cdaub-bu/GS_Circuit/KiCad/GS_Circuit/GS_Circuit.csv

Reference | Qty | Value | DIGIKEY | CatNo
J1 | 1 | AVR-ISP-6
XX7 | 1 | Cap Blue | 1DBLU-ND | 1DBLU-ND
XX2 | 1 | Green LED | 1516-1364-ND | 1516-1364-ND
XX4 | 1 | Blue LED | 1516-1365-ND | 1516-1365-ND
XX1 | 1 | White LED | 1516-QBL8IW60D-CW-ND | 1516-QBL8IW60D-CW-ND
XX5 | 1 | DIP-8 Socket | 2057-ICS-308-T-ND | 2057-ICS-308-T-ND
BT1 | 1 | Battery | 36-2464-ND
C1 | 1 | .1 uf | 445-173588-1-ND
XX3 | 1 | Red LED | 67-2288-ND | 67-2288-ND
S1 | 1 | TEPT 4400 | 751-1057-ND
U2 | 1 | ATtiny85V-10P | ATTINY85-20PU-ND
R3,R4 | 2 | 10K | CF14JT10K0CT-ND
R1,R2 | 2 | 91 Ohms | CF14JT91R0CT-ND
XX6 | 1 | Cap Red | EG1195-ND | EG1195-ND
SW2 | 1 | SW_SPST | EG5886-ND
SW1 | 1 | SW_Push | EG5888-ND
D1,D2 | 2 | LED | Various
