cdaub-bu/GS_Circuit/Case/Final/SolderJig3.stl

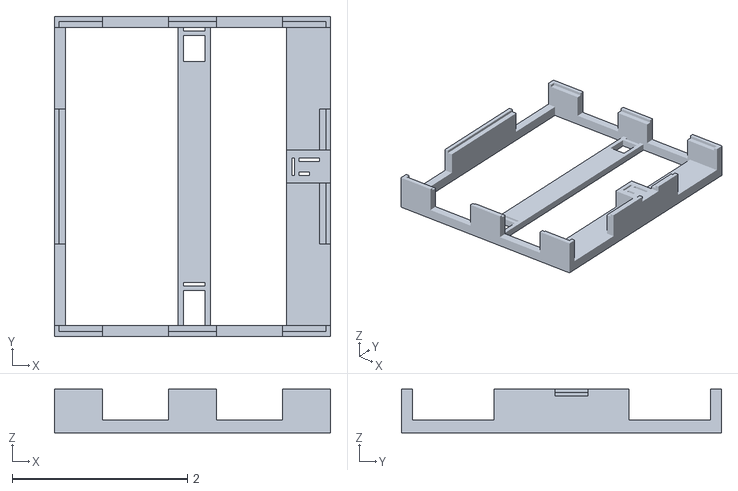
[picture p2: CAD file, 2026-02-10]
Case/Final/SolderJig3.stl
3.15 x 3.65 x 0.5
