cdaub-bu/GS_Circuit/KiCad/GS_Circuit/models/LC1258EENP.step

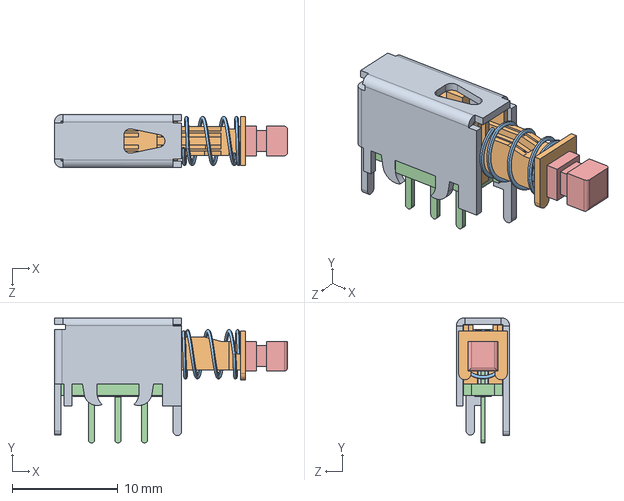
[picture p3: CAD file, 2026-02-01]
KiCad/GS_Circuit/models/LC1258EENP.step
22.0 x 11.8 x 5.00 mm
