cdaub-bu/GS_Circuit/KiCad/GS_Circuit/GS_Circuit.pdf

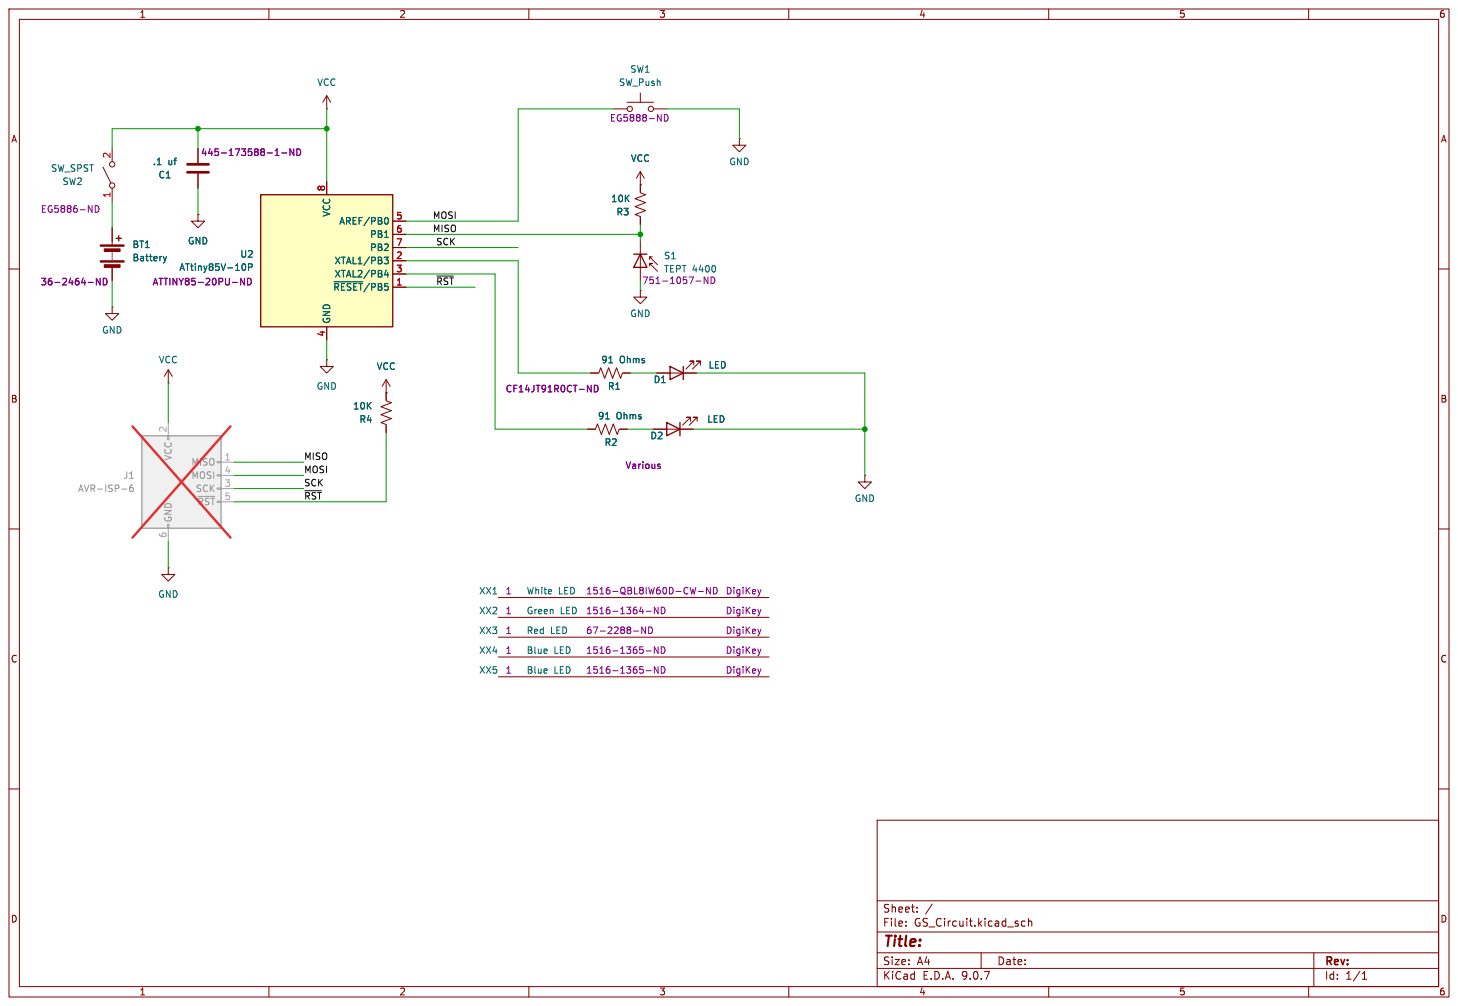
[picture p4: page 1]

4 AREF/PB0 5 PB1 6 PB2 7 XTAL1/PB3 2 XTAL2/PB4 3 ~{RESET}/PB51 BT1 Battery 36-2464-ND

6 MISO 1 MOSI 4 SCK 3 ~{RST}5

Id: 1/1 Title: File: GS_Circuit.kicad_sch Sheet: /
