cdaub-bu/GS_Circuit/KiCad/GS_Circuit/GS_Circuit.kicad_pcb

## KiCad design KiCad/GS_Circuit/GS_Circuit.kicad_pcb (2026-01-20)

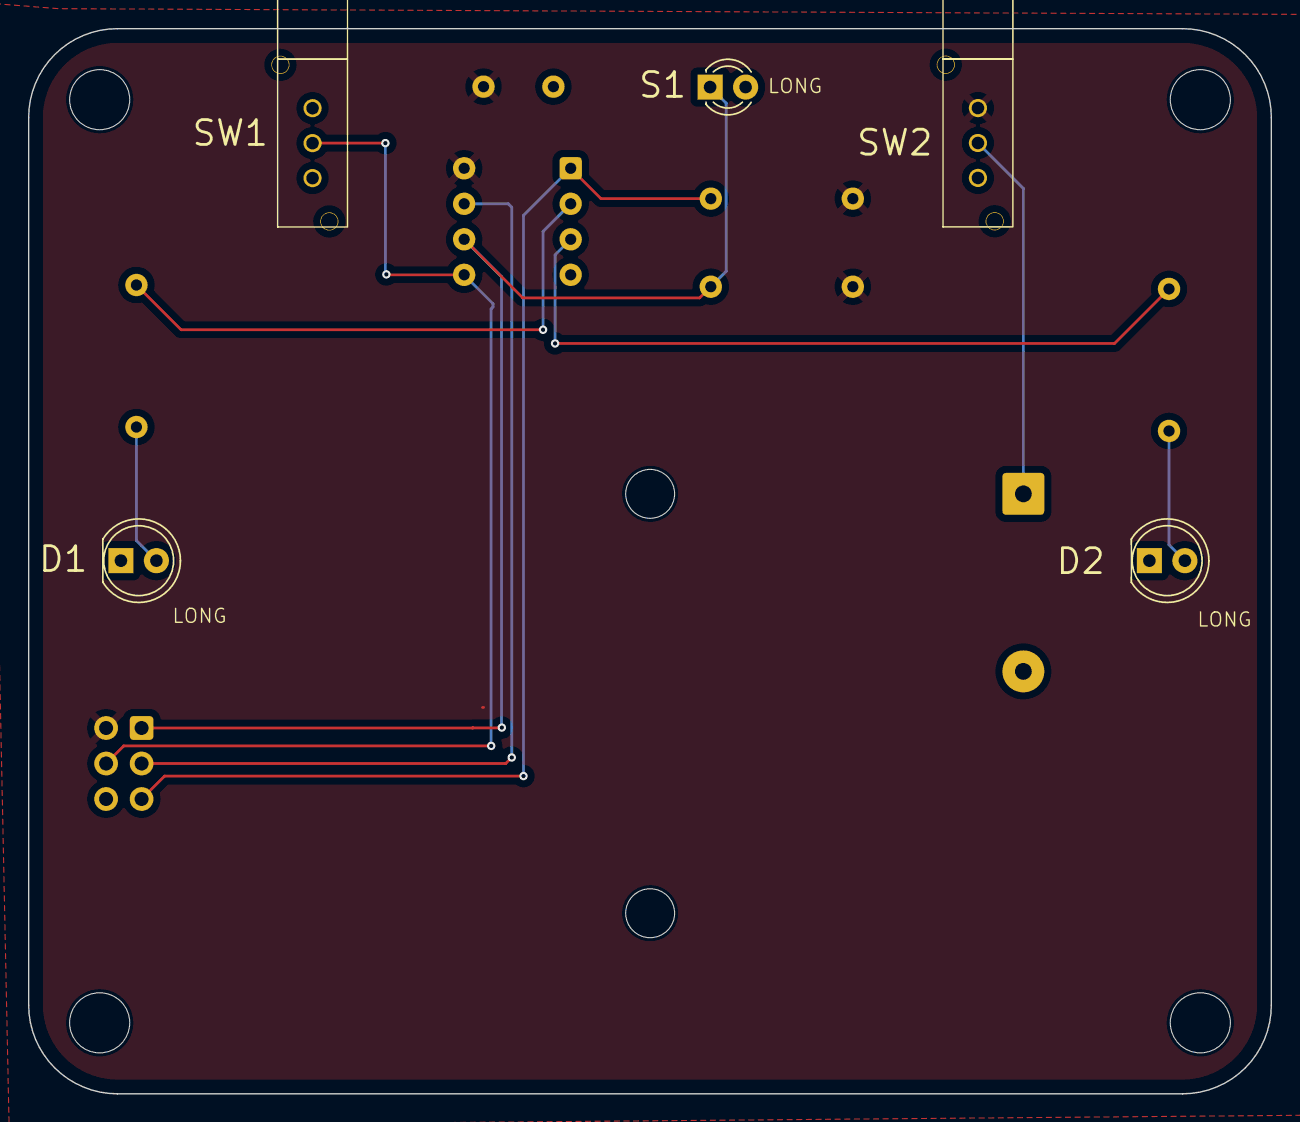
[picture p5: board GS_Circuit.kicad_pcb from above]

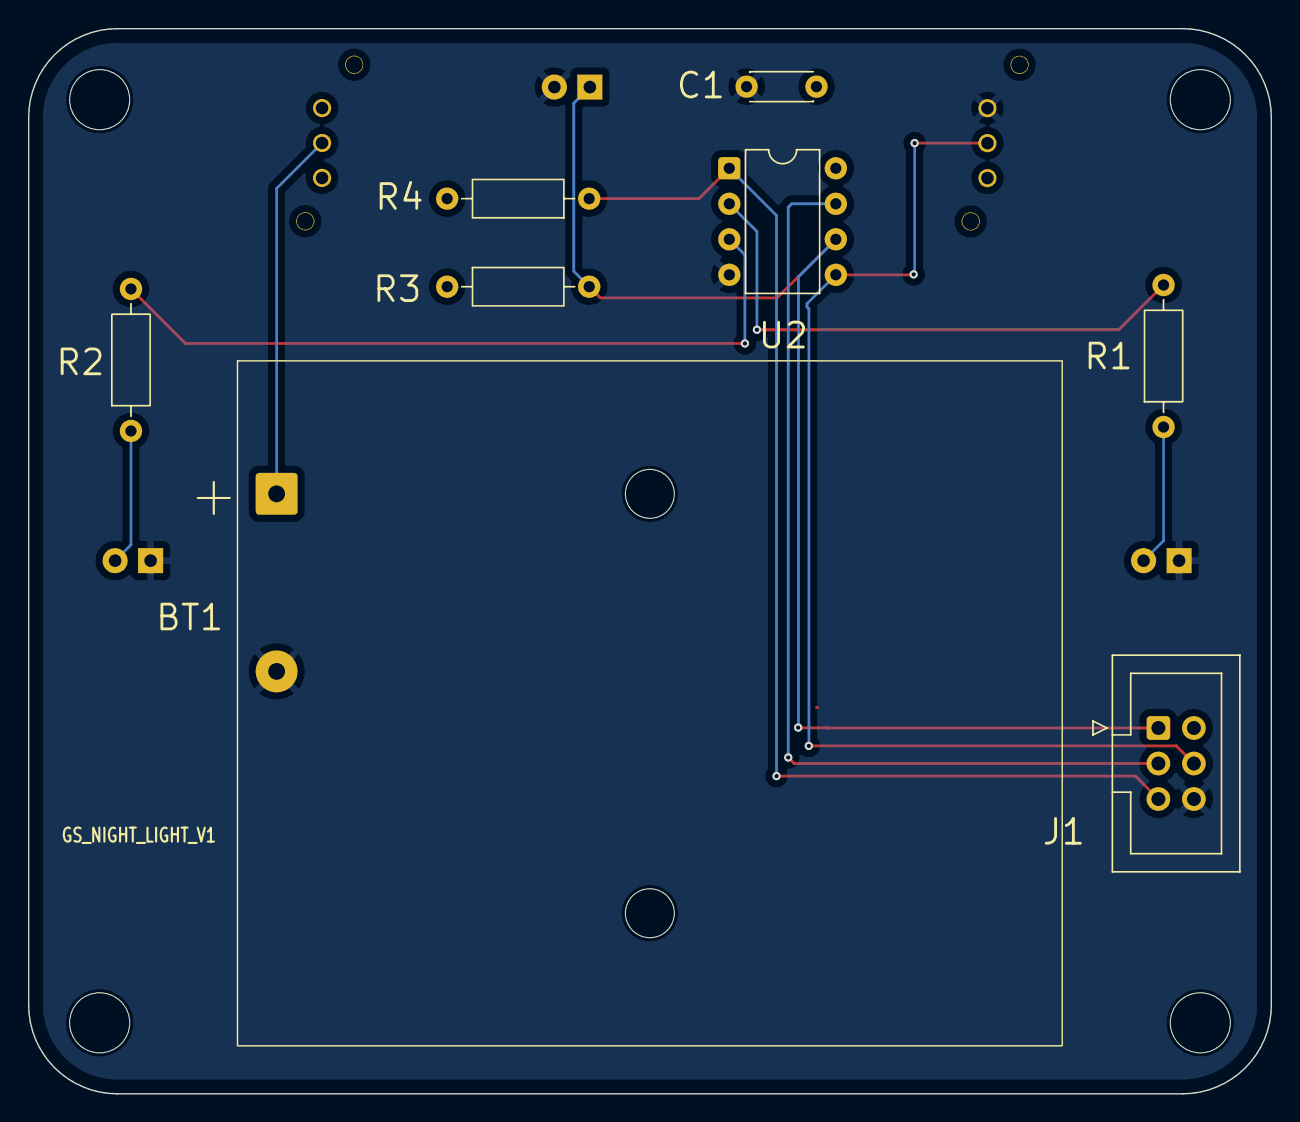
[picture p6: board GS_Circuit.kicad_pcb from below]

Board: 2 copper layers, 88.9 x 76.2 mm, 17 parts (8 on the bottom side), 11 nets.

Parts:
BT1: Battery; BatteryHolder_Keystone_2464
C1: .1 uf; C_Disc_D4.3mm_W1.9mm_P5.00mm
D1, D2: LED, QBL8XX60Y Series; LED_D5.0mm
H1, H2, H3, H4: MountingHole; MountingHole_4.3mm_M4
J1: AVR-ISP-6; IDC-Header_2x03_P2.54mm_Vertical
R1, R2: 91 Ohms; R_Axial_DIN0207_L6.3mm_D2.5mm_P10.16mm_Horizontal
R3: 10K; R_Axial_DIN0207_L6.3mm_D2.5mm_P10.16mm_Horizontal
R4: R_US; R_Axial_DIN0207_L6.3mm_D2.5mm_P10.16mm_Horizontal
S1: TEPT 4400; THT_TEPT4400
SW1: SW_Push; LC 1258
SW2: SW_SPST; LC 1258
U2: ATtiny85V-10P; DIP-8_W7.62mm

Connections:
/MISO: J1.1 (MISO), R3.2, S1.1 (K), U2.6 (PB1)
/MOSI: J1.4 (MOSI), SW1.1, U2.5 (AREF/PB0)
/SCK: J1.3 (SCK), U2.7 (PB2)
/~RST: J1.5 (~RST), R4.1, U2.1 (~RESET/PB5)
GND: BT1.2 (-), C1.2, D1.1 (K), D2.1 (K), J1.6 (GND), S1.2 (A), SW1.2, U2.4 (GND)
unnamed: BT1.1 (+), SW2.1 (A)
unnamed: D1.2 (A), R1.1
unnamed: D2.2 (A), R2.1
unnamed: R1.2, U2.2 (XTAL1/PB3)
unnamed: R2.2, U2.3 (XTAL2/PB4)
VCC: C1.1, J1.2 (VCC), R3.1, R4.2, SW2.2 (B), U2.8 (VCC)
