cdaub-bu/GS_Circuit/Software/Testing/dimmer/main.c

/*
 * simple dimmer example
 * use timer 0 interrupt at 10kHz to generate 0-99% at 100Hz PWM rate
 */

// reversed pushbutton (NC) 
#define SW_NC

// #define USE_UART
#define USE_ACOMP

// if 1M pull-up to LDR is wired to pin 7
// #define PUP_MOD

// goto sleep and turn off after this many ticks of 100Hz
#define SLEEP_TIME 60

#include <stdio.h>
#include <avr/io.h>
#include <util/delay.h>
#include <stdint.h>
#include <avr/interrupt.h>
#include <avr/sleep.h>
#include <avr/power.h>

#include "timer_10kHz.h"

#ifdef USE_UART
#include "uart.h"
#endif

#ifdef USE_ACOMP
#include "acomp.h"
#endif

#ifdef SLEEP_TIME
#include "sleep.h"
#endif

#define LED_DDR DDRB
#define LED_BIT 3
#define LED2_BIT 4
#define LED_MASK (_BV(LED_BIT)|_BV(LED2_BIT))
#define LED_PORT PORTB

#ifdef PUP_MOD
#define PUP_DDR DDRB
#define PUP_BIT 2
#define PUP_PORT PORTB
#endif

#define SW_DDR DDRB
#define SW_BIT 0
#define SW_PORT PORTB
#define SW_PIN PINB

volatile uint8_t tick;
volatile uint16_t long_tick;
volatile int8_t pct = 1;

#define PERIOD 100

// Timer0 Compare Match A ISR (10 kHz)
// dim the 
ISR(TIMER0_COMPA_vect)
{
  ++tick;
  if( tick == PERIOD) {
    tick = 0;
    ++long_tick;
  }
  if( tick < pct)
    LED_PORT |= LED_MASK;
  else
    LED_PORT &= ~LED_MASK;
}

#ifdef SLEEP_TIME
ISR(PCINT0_vect)
{
    // Executed after wake-up
    // Keep this ISR short
}
#endif

uint8_t dim[] = { 0, 1, 2, 5, 10, 20, 50, 99 };
#define NDIM (sizeof(dim)/sizeof(dim[0]))
static int level;

static int bounce;
#define DEBOUNCE 50

static uint16_t adcv;

void flash_led( int n) {
      // flash the LED
  for( int i=0; i<n; i++) {
    pct = dim[3];
    _delay_ms(25);
    pct = 0;
    _delay_ms(25);
  }
}

int main (void)
{
#ifdef PUP_MOD
  // enable PB2 as output for pull-up on the light sensor
  PUP_DDR |= _BV(PUP_BIT);
  PUP_PORT |= _BV(PUP_BIT);
#endif
  
  SW_PORT |= _BV( SW_BIT);	/* enable pull-up */
  LED_DDR |= LED_MASK;

  // turn off BOD in sleep to reduce power
  MCUCR |= _BV(BODS) | _BV(BODSE);
  MCUCR |= _BV(BODS);
  power_adc_disable();  

  timer0_init_10kHz();


#ifdef USE_UART
  uart_tx_init();
#endif
#ifdef USE_ACOMP
  acomp_init();
#endif  
#ifdef SLEEP_TIME
  long_tick = 0;
#endif  


  bounce = DEBOUNCE;
  level = 1;
  pct = 0;

  while( 1) {
    _delay_ms(3);

    if( bounce)
      --bounce;
    else {
#ifdef SW_NC
      if( (SW_PIN & _BV(SW_BIT)) != 0) { /* switch pressed */
#else
      if( (SW_PIN & _BV(SW_BIT)) == 0) { /* switch pressed */
#endif
	bounce = DEBOUNCE;
	++level;
	if( level >= NDIM)
	  level = 0;
      }
    }

#ifdef USE_UART
    uart_tx_byte( adcv);
    uart_tx_byte( adcv >> 8);
#endif
    
#ifdef USE_ACOMP
    if( acomp_read())
      adcv = 0;
    else
      adcv = 0xffff;
#endif    

    if( adcv >= 0x300)
      pct = dim[level];
    else
      pct = 0;

#ifdef SLEEP_TIME
    if( long_tick > SLEEP_TIME) {

      flash_led(10);

#ifdef PUP_MOD
      // turn off LDR pull-up
      PUP_PORT &= ~_BV(PUP_BIT);
#endif
      // go to sleep
      long_tick = 0;

      cli();		/* disable interrupts while setting up */

      /* Disable unused peripherals to save power */
      ADCSRA &= ~(1 << ADEN);   // Disable ADC
      power_all_disable();

      /* Configure PB0 as input */
      DDRB &= ~(1 << PB0);
      PORTB |= (1 << PB0);      // Enable pull-up (optional)

      /* Enable pin-change interrupt on PB0 */
      PCMSK |= (1 << PCINT0);   // Unmask PCINT0
      GIMSK |= (1 << PCIE);     // Enable pin-change interrupts

      // turn off the comparator (saves 18uA!)
      ACSR |= _BV(ACD);

      sei();                    // Enable global interrupts

      set_sleep_mode( SLEEP_MODE_PWR_DOWN);
      sleep_enable();
      sleep_cpu();

      // come here on wake-up
      sleep_disable();
      power_all_enable();
      power_adc_disable();

      long_tick = 0;
      pct = dim[level];

#ifdef PUP_MOD
      PUP_PORT |= _BV(PUP_BIT);
#endif

      // turn the comparator back on
      ACSR &= ~_BV(ACD);

      acomp_init();
      flash_led(5);
    }
#endif    
    
  }
}
