cdaub-bu/GS_Circuit/(commit log)

2026-01-15 Initial Circuit Files
    [GS_Circuit.kicad_pcb, GS_Circuit.kicad_sch]
2026-01-16 Foot Print and Componentry
    First Try at foot print.
    LEDs are sourced
    Need help on switches.
    [GS_Circuit.kicad_pcb, GS_Circuit.kicad_sch]
2026-01-17 First try foot print
    Added library components with foot prints. (photo sensor and switches).
    First draft at PCB layout.
    [GS_Circuit.kicad_pcb, GS_Circuit.kicad_sch]
2026-01-18 MD Electron Feedback 1
    -Changed Library Structure
    -Fixed switch footprint issue
    -Added PCB over all footprint and layout
    -Moved silkscreen labels
    -
    [GS_Circuit.kicad_pcb, GS_Circuit.kicad_sch]
2026-01-19 Fixed Battery Layout
    [GS_Circuit.kicad_pcb, GS_Circuit.kicad_sch]
2026-01-19 MD e-negative feedback 2
    - Moved capacitor & rotate
    - Updated foot prints for LEDS
    - Added BOM
    [GS_Circuit.kicad_sch]
2026-01-19 Loose Saves
    [GS_Circuit.kicad_pcb, GS_Circuit.kicad_sch]
2026-01-19 MD E Feeback 3
    Moved Lights
    Horizontal/Vertical Wiring
    [GS_Circuit.kicad_pcb, GS_Circuit.kicad_sch]
2026-01-20 Moved lights to border
    [GS_Circuit.kicad_pcb]
2026-01-20 Fixed Connecions for LEDS
    [GS_Circuit.kicad_pcb]
2026-01-20 Rev 1 as built
    [GS_Circuit-B_Cu.gbr, GS_Circuit-B_Mask.gbr, GS_Circuit-B_Silkscreen.gbr, GS_Circuit-Edge_Cuts.gbr, GS_Circuit-F_Cu.gbr, GS_Circuit-F_Mask.gbr, GS_Circuit-F_Silkscreen.gbr, GS_Circuit-NPTH.drl]
2026-01-28 working on reducing the sleep power
2026-02-01 Rev 1 PCB, working on software
    [LC1258EENP.step]
2026-02-04 working on light sensor
2026-02-09 sensor test
2026-02-10 work on software
    [SolderJig3.stl]
2026-02-10 simple working version no pin change wakeup 0.5uA
